Natthabhat/Mech-Machinery-2026-/hardware/mechanical/cad/M6 rod end ball.step

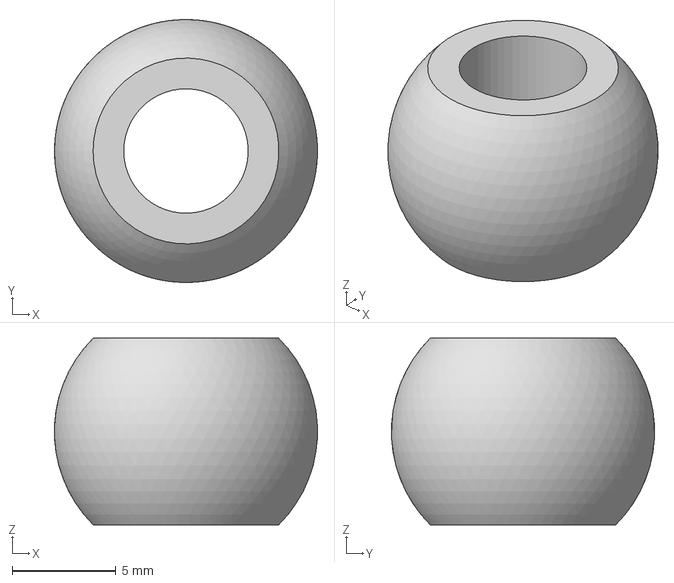
[picture p15: CAD file, 2026-11-11]
hardware/mechanical/cad/M6 rod end ball.step
12.7 x 12.7 x 9.00 mm
