Natthabhat/Mech-Machinery-2026-/hardware/mechanical/cad/Small Drum v5.STEP

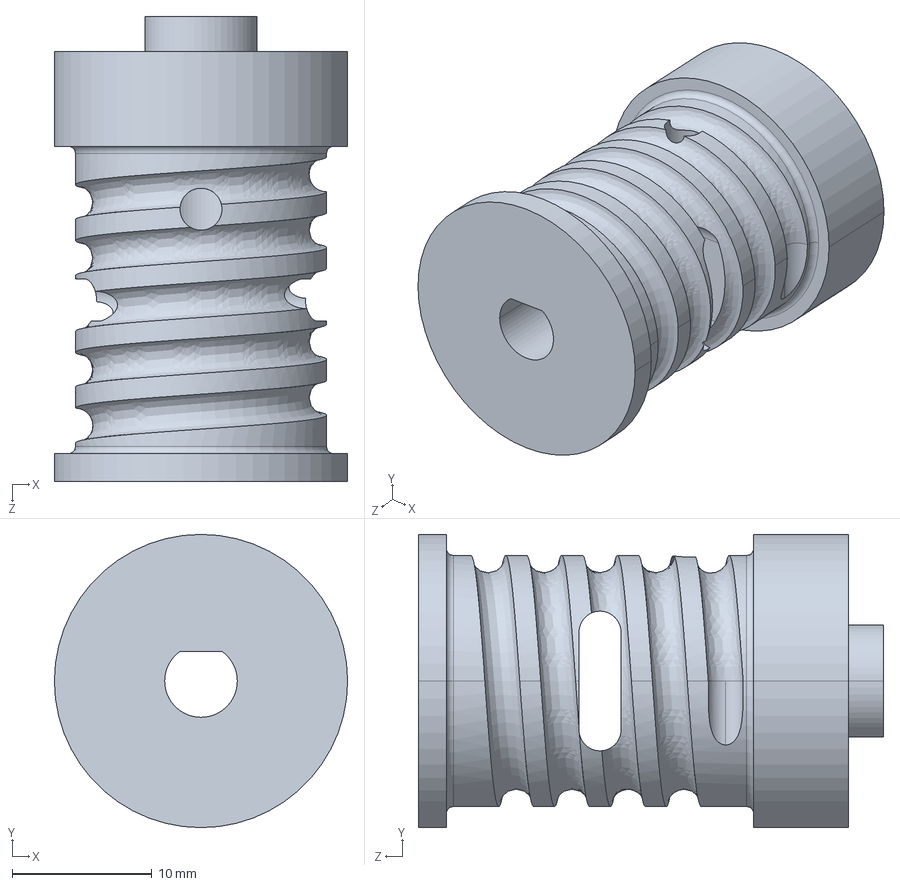
[picture p16: CAD file, 2026-11-11]
hardware/mechanical/cad/Small Drum v5.STEP
21.0 x 21.0 x 33.3 mm
