Natthabhat/Mech-Machinery-2026-/hardware/mechanical/cad/Link V.2.step

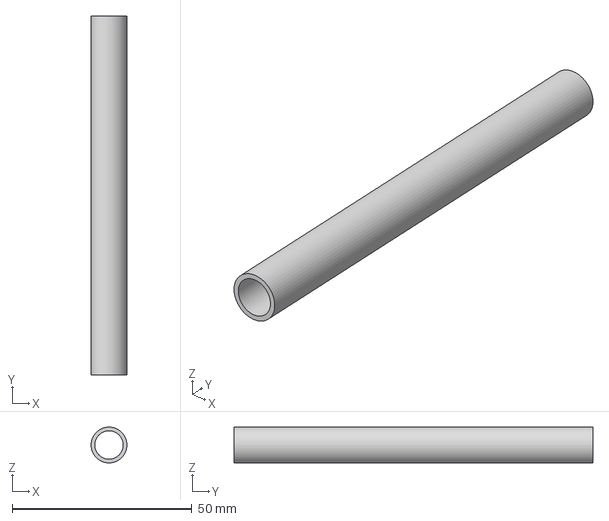
[picture p17: CAD file, 2026-11-11]
hardware/mechanical/cad/Link V.2.step
9.99 x 100.0 x 10.00 mm
