Natthabhat/Mech-Machinery-2026-/hardware/mechanical/cad/Motor Bracket v6.STEP

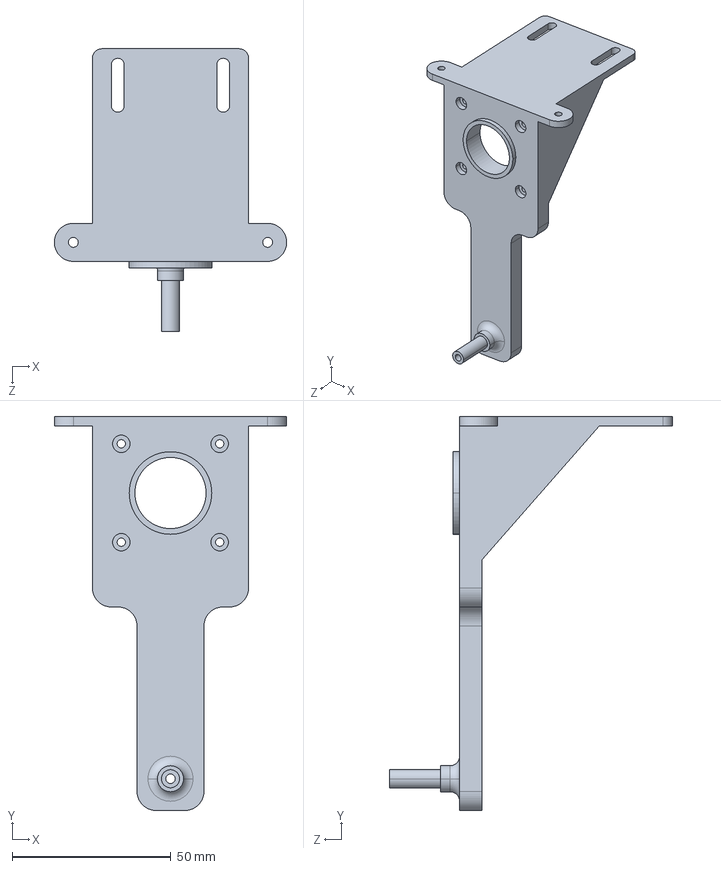
[picture p18: CAD file, 2026-11-11]
hardware/mechanical/cad/Motor Bracket v6.STEP
73.2 x 124.1 x 89.0 mm
