Natthabhat/Mech-Machinery-2026-/hardware/mechanical/cad/M6 Rod End L51.step

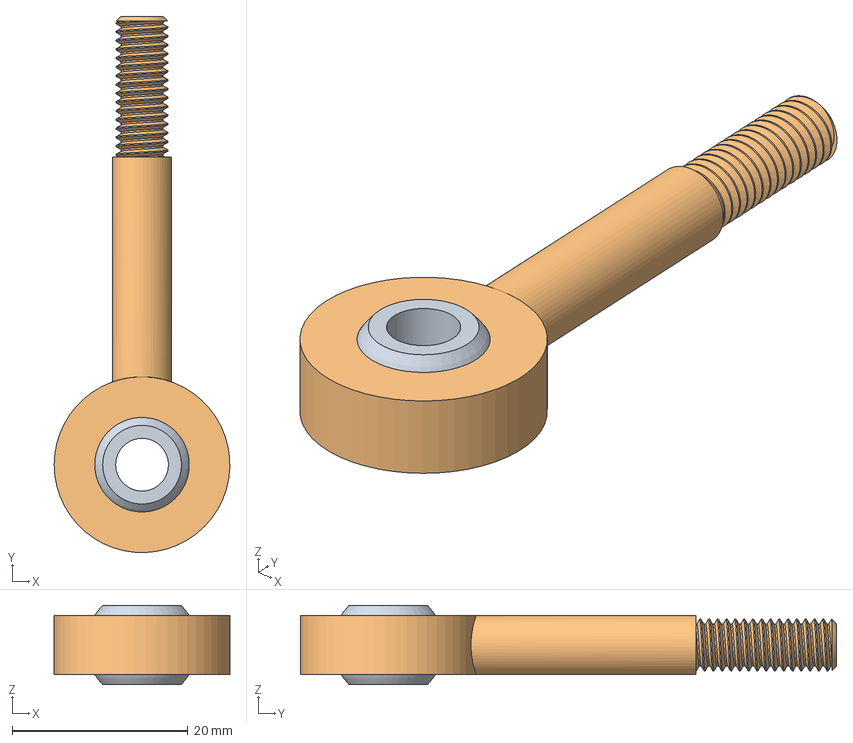
[picture p19: CAD file, 2026-11-11]
hardware/mechanical/cad/M6 Rod End L51.step
20.0 x 61.0 x 9.00 mm
