Natthabhat/Mech-Machinery-2026-/hardware/mechanical/cad/connector v6.STEP

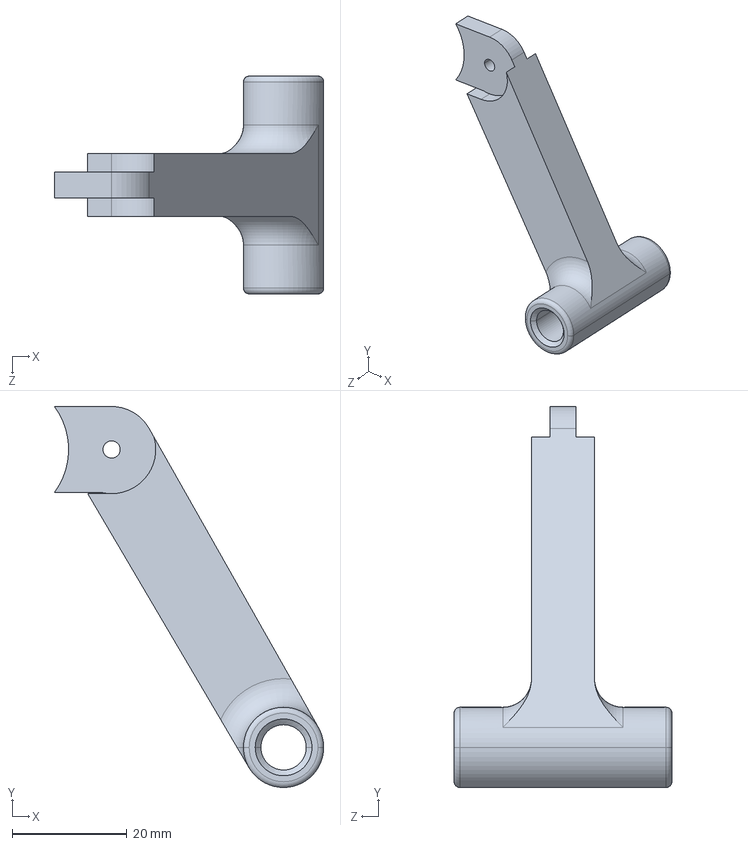
[picture p20: CAD file, 2026-11-11]
hardware/mechanical/cad/connector v6.STEP
47.0 x 66.5 x 38.0 mm
