Natthabhat/Mech-Machinery-2026-/hardware/mechanical/cad/M6 rod end housing L51.step

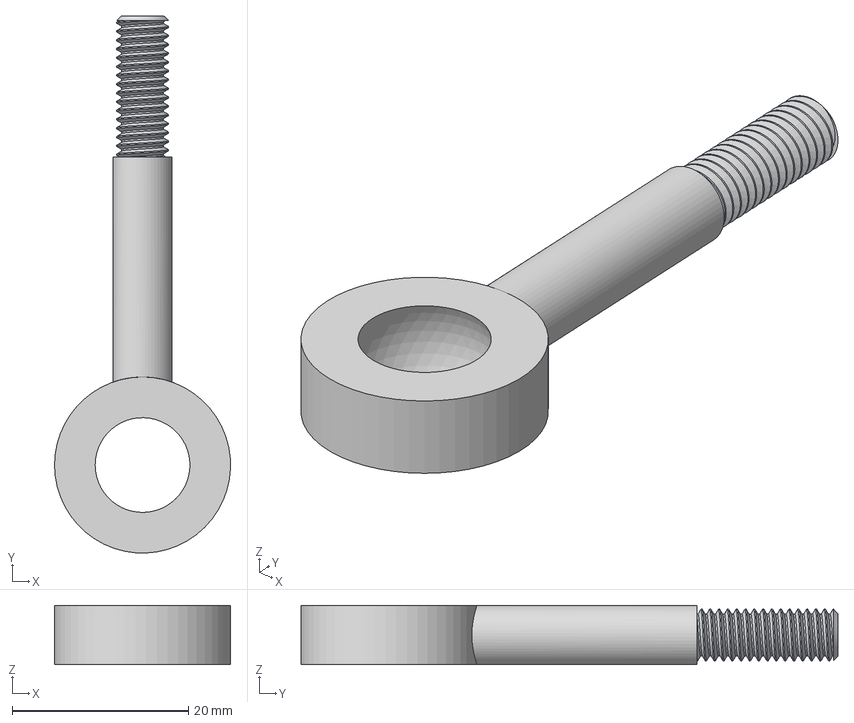
[picture p21: CAD file, 2026-11-11]
hardware/mechanical/cad/M6 rod end housing L51.step
20.0 x 61.0 x 6.75 mm
