Natthabhat/Mech-Machinery-2026-/hardware/mechanical/cad/Nema17 42BYGH40.step

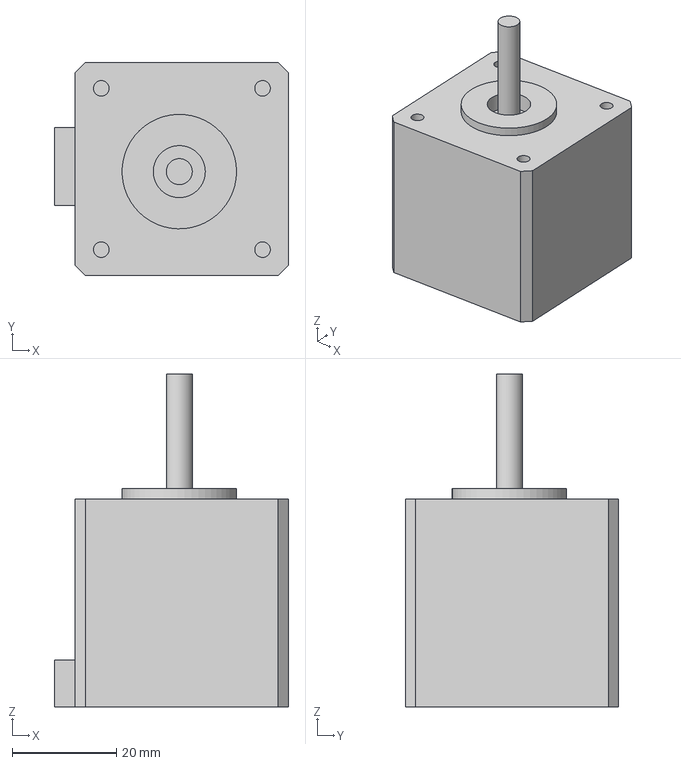
[picture p22: CAD file, 2026-11-11]
hardware/mechanical/cad/Nema17 42BYGH40.step
45.0 x 41.0 x 64.0 mm
