Natthabhat/Mech-Machinery-2026-/hardware/mechanical/cad/hand V.3.step

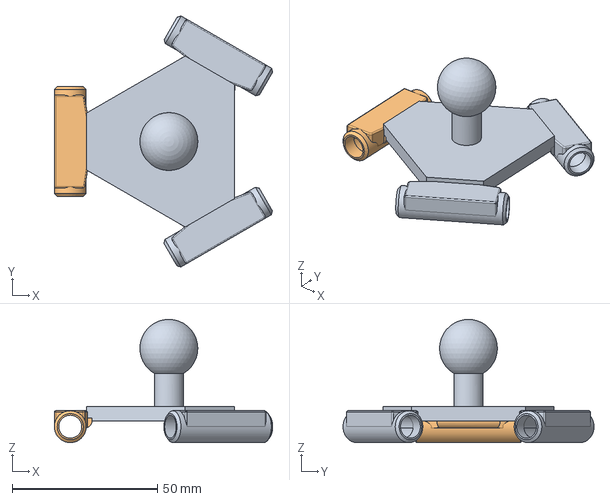
[picture p23: CAD file, 2026-11-11]
hardware/mechanical/cad/hand V.3.step
75.3 x 86.5 x 42.5 mm
