Natthabhat/Mech-Machinery-2026-/hardware/mechanical/cad/Base V4.step

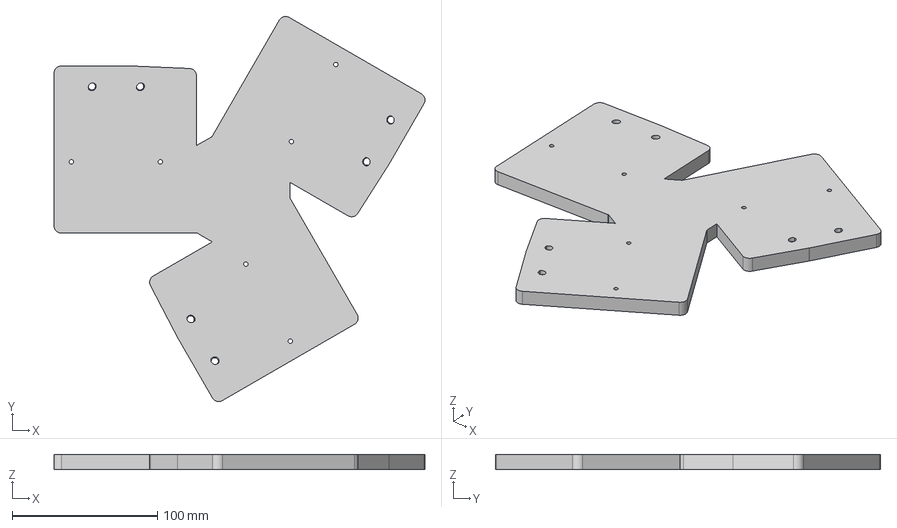
[picture p24: CAD file, 2026-11-11]
hardware/mechanical/cad/Base V4.step
255.3 x 265.0 x 10.0 mm
