Natthabhat/Mech-Machinery-2026-/hardware/mechanical/cad/Big Drum V6.STEP

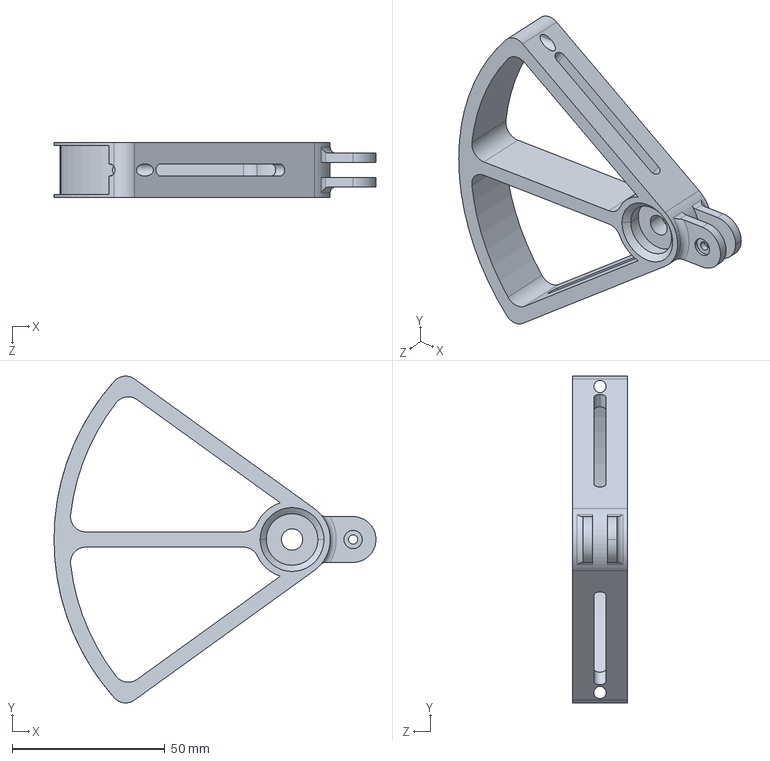
[picture p25: CAD file, 2026-11-11]
hardware/mechanical/cad/Big Drum V6.STEP
105.5 x 107.1 x 18.0 mm
