Natthabhat/Mech-Machinery-2026-/hardware/mechanical/cad/606ZZ.step

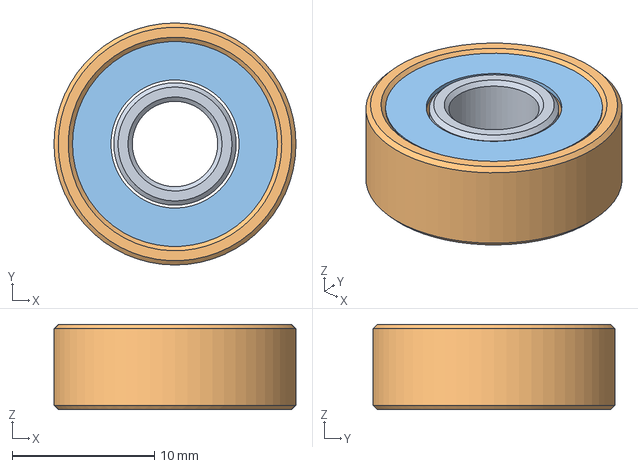
[picture p26: CAD file, 2026-11-11]
hardware/mechanical/cad/606ZZ.step
17.0 x 17.0 x 6.00 mm
