Natthabhat/Mech-Machinery-2026-/hardware/mechanical/cad/M3x6 ISO4762.step

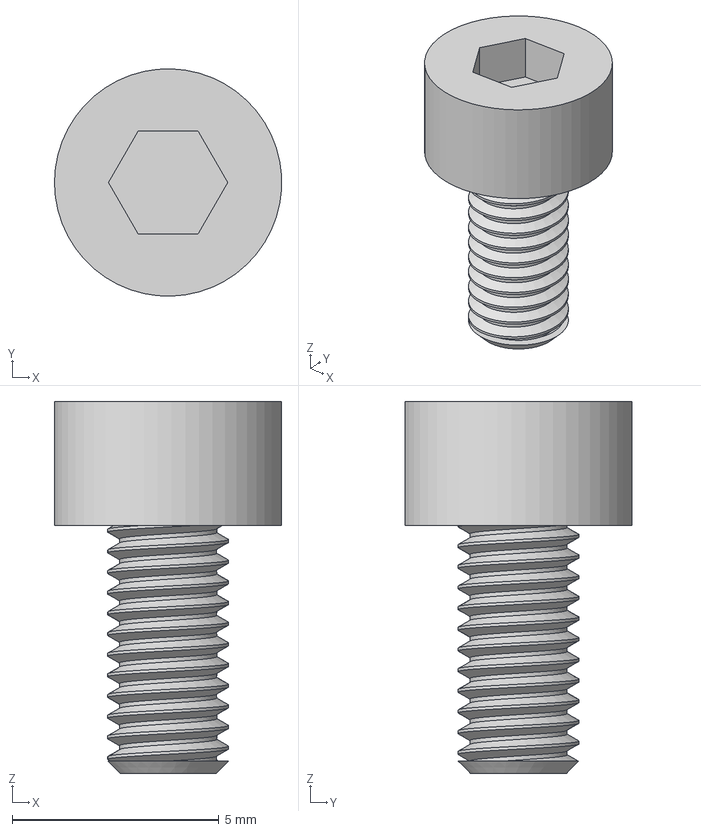
[picture p27: CAD file, 2026-11-11]
hardware/mechanical/cad/M3x6 ISO4762.step
5.49 x 5.50 x 9.00 mm
