Natthabhat/Mech-Machinery-2026-/hardware/mechanical/cad/M3 nut ISO4032.step

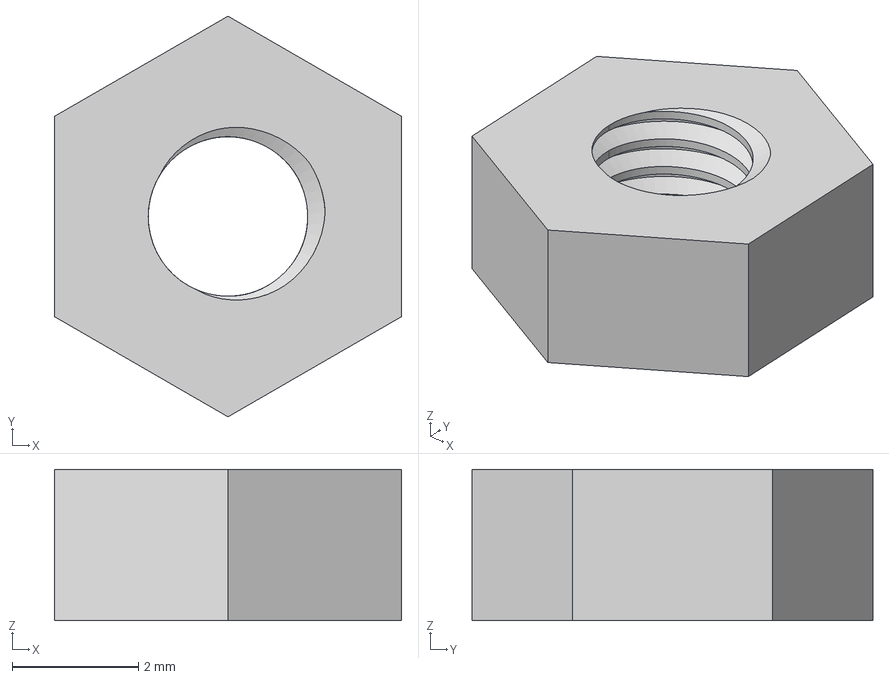
[picture p28: CAD file, 2026-11-11]
hardware/mechanical/cad/M3 nut ISO4032.step
5.50 x 6.35 x 2.40 mm
