Natthabhat/Mech-Machinery-2026-/hardware/mechanical/cad/M3x10 ISO4762.step

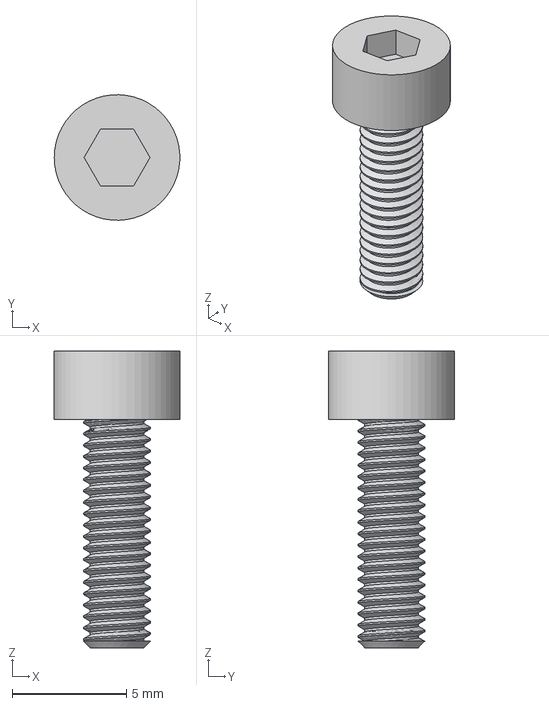
[picture p29: CAD file, 2026-11-11]
hardware/mechanical/cad/M3x10 ISO4762.step
5.49 x 5.50 x 13.0 mm
