Natthabhat/Mech-Machinery-2026-/hardware/mechanical/cad/M6x12 ISO4762.step

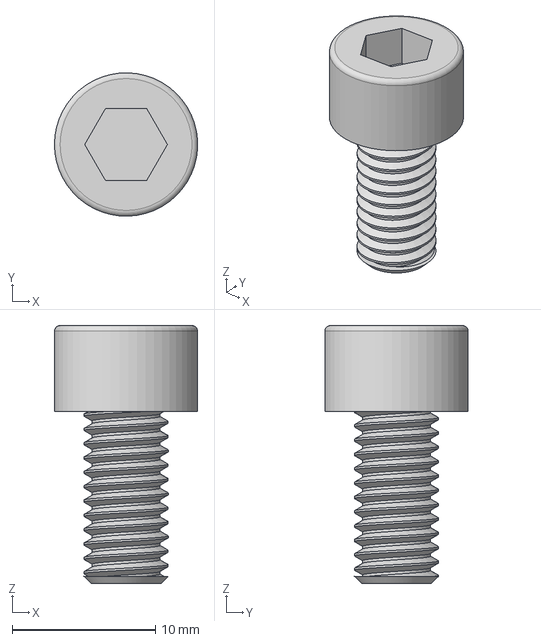
[picture p30: CAD file, 2026-11-11]
hardware/mechanical/cad/M6x12 ISO4762.step
9.99 x 10.00 x 18.0 mm
