Natthabhat/Mech-Machinery-2026-/(commit log)

2026-11-11 Add delta haptic CAD, Simscape model and symbolic kinematics
    - hardware/mechanical/cad: final STEP files of printed and bought parts
    - hardware/mechanical/fusion-scripts: ISO 4762 screw generator for Fusion 360
    - simulation: Simscape Multibody model builder, checks, circle/helix demos,
    symbolic kinematics/dynamics and fanimator animation (MATLAB R2026a)
    - media: animation frame and shoulder kinematics plot
    - READMEs: project overview, quick start, parts list, results, assumptions
    [606ZZ.step, Base V4.step, Big Drum Bushing.STEP, Big Drum V6.STEP, Link V.2.step, M2.5x6 ISO4762.step, M3 nut ISO4032.step, M3x10 ISO4762.step]
2026-11-11 Add prototype photos (downscaled, metadata removed)
2026-11-11 README: device details, assumptions and known limitations
2026-11-11 Docs: symbolic math part 1, points of one leg (side and top view diagrams)
2026-11-11 Docs: symbolic math part 4, velocity and the Jacobian
2026-11-11 Simulation: as-built part colours, find STEP files in Model/ or the repo CAD folder
2026-11-11 Use all weighed masses, M3x6 motor screws; remove unused STEP files
    - info.txt weights: hand 12.9 g, 606ZZ 5.7 g, M6x12 6.3 g, M3x6 0.66 g,
    M3x10 + nut 1.51 g now used as masses in the model
    - motor-to-bracket screws M2.5x6 -> M3x6
    - removed M2.5x6, Shaft End and Big Drum Bushing STEP files (not used)
    - reran symbolic derivation: M_q 0.824 g m^2, m_p 191.1 g, gravity
    compensation 10.7 mN m per motor; docs and READMEs updated
    [Big Drum Bushing.STEP, M2.5x6 ISO4762.step, Shaft End.STEP]
2026-11-11 Remove Fusion 360 screw script from the repo
2026-11-12 Media: final unit photos in media/, captions removed, keep 3 prototype photos
2026-11-12 README: remove the CAD-geometry / La assumption
2026-11-12 Docs: part 8, degrees of freedom (joint list, Grubler-Kutzbach) and kinematic diagram
